virtualabs/NSC14-HW/slides/images/rf-remote-power.png

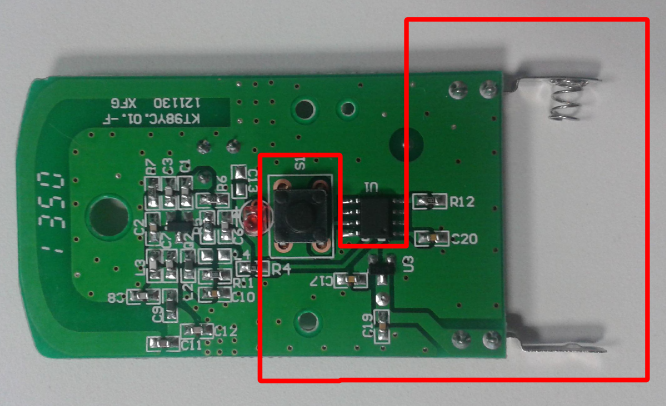
slides/images/rf-remote-power.png
