virtualabs/NSC14-HW/slides/images/rf-teardown-rf.png

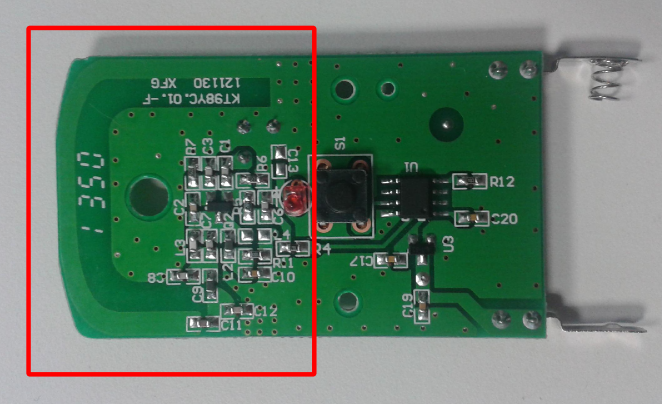
slides/images/rf-teardown-rf.png
