virtualabs/NSC14-HW/README.md

NSC14 Hardware Workshop materials
=================================

In this repository, you'll find:

* my slides (HTML format)
* gEDA design files to produce the PCB for this workshop (gerber files provided as well)
* a building guide to follow (PDF)

The target wireless door bell is: http://www.leroymerlin.fr/v3/p/produits/carillon-sans-fil-evology-fdm-qa-698s-e134887

Have fun with it ;)
