virtualabs/NSC14-HW/slides/images/rf-remote-bf.png

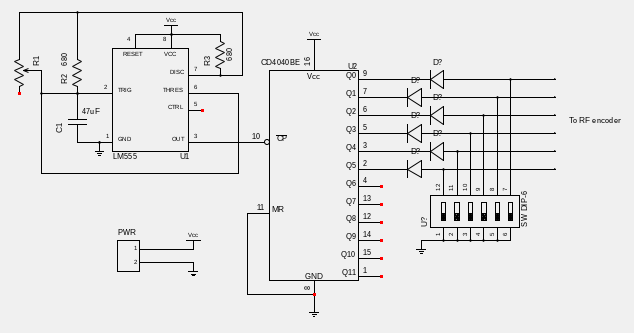
slides/images/rf-remote-bf.png
