virtualabs/NSC14-HW/slides/images/rf-remote-uc.png

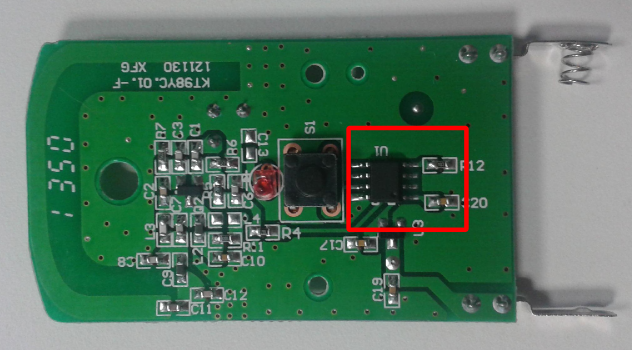
slides/images/rf-remote-uc.png
