virtualabs/NSC14-HW/slides/images/select-code.png

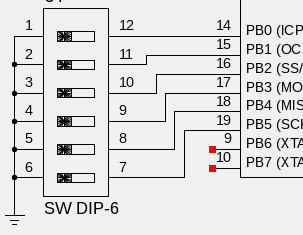
slides/images/select-code.png
