virtualabs/NSC14-HW/(list of files, drawings)

Other design files:
design-files/rf-remote.pcb
